athifashaffy/tsf-digital-twin/hardware/print/stl/box_lid.stl

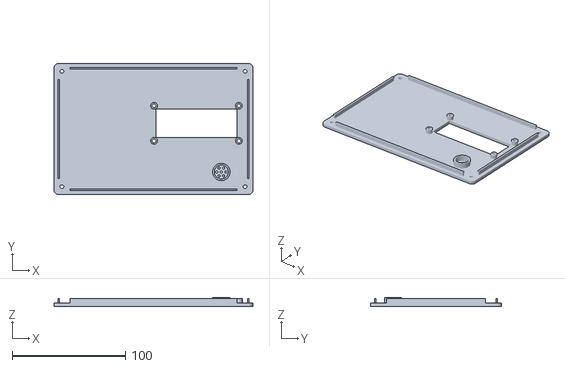
[picture p1: CAD file, 2026-10-17]
hardware/print/stl/box_lid.stl
176.0 x 116.0 x 8.00
