athifashaffy/tsf-digital-twin/hardware/print/stl/sonar_holder.stl

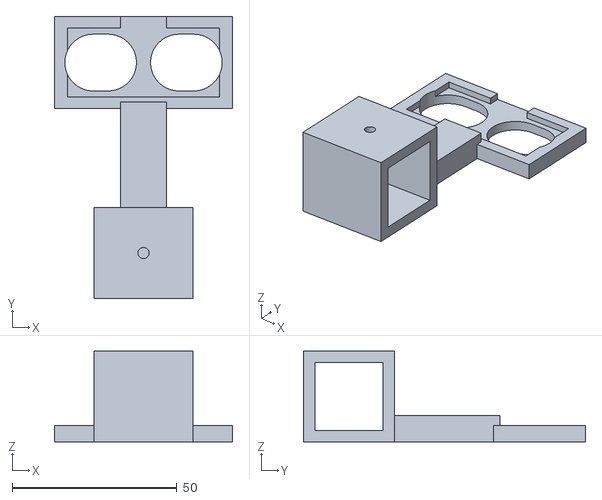
[picture p2: CAD file, 2026-10-17]
hardware/print/stl/sonar_holder.stl
54.0 x 85.6 x 27.6
