athifashaffy/tsf-digital-twin/hardware/print/stl/flow_cradle.stl

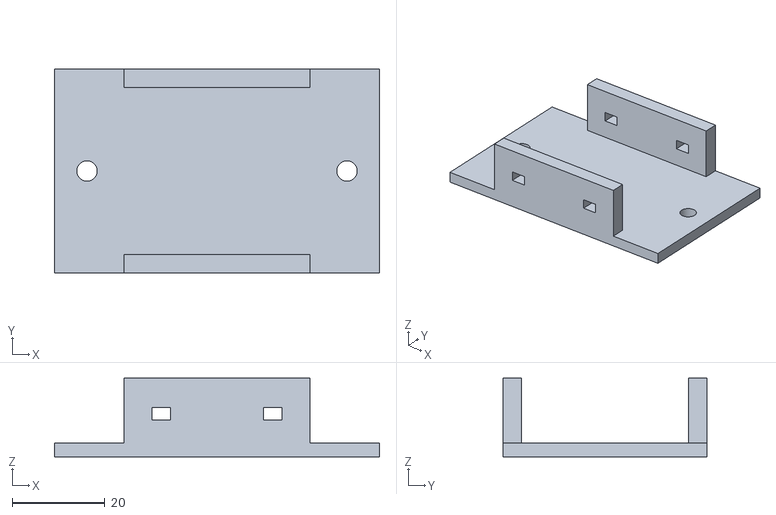
[picture p3: CAD file, 2026-10-17]
hardware/print/stl/flow_cradle.stl
70.0 x 44.0 x 17.0
