athifashaffy/tsf-digital-twin/hardware/print/stl/probe_hanger_x2.stl

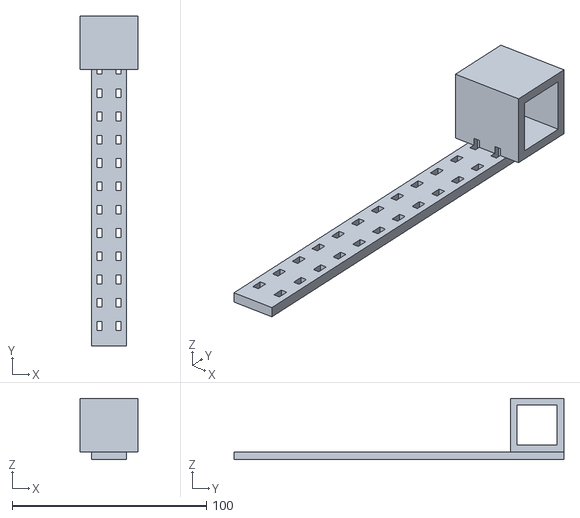
[picture p4: CAD file, 2026-10-17]
hardware/print/stl/probe_hanger_x2.stl
30.0 x 170.0 x 31.6
