athifashaffy/tsf-digital-twin/hardware/print/stl/rim_clamp_x2.stl

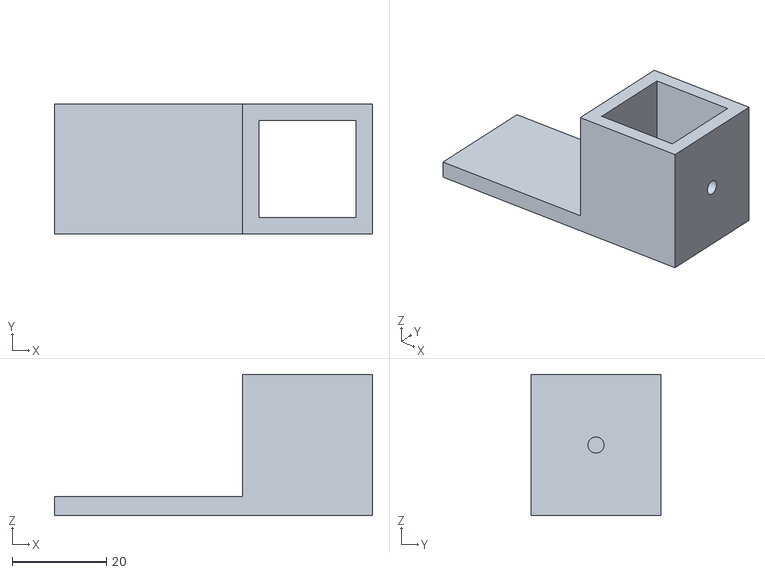
[picture p5: CAD file, 2026-10-17]
hardware/print/stl/rim_clamp_x2.stl
67.6 x 27.6 x 30.0
