athifashaffy/tsf-digital-twin/hardware/print/stl/saddle.stl

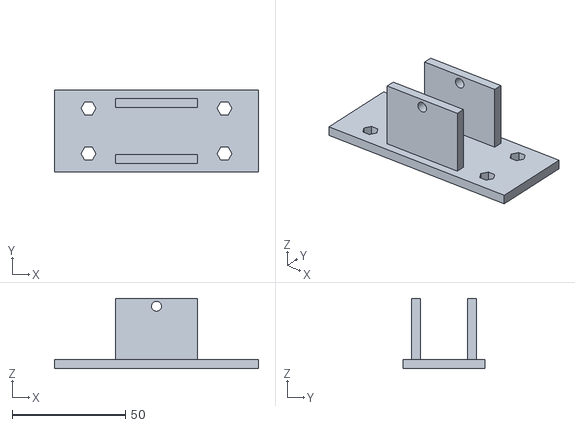
[picture p6: CAD file, 2026-10-17]
hardware/print/stl/saddle.stl
90.0 x 36.0 x 31.0
