athifashaffy/tsf-digital-twin/hardware/print/stl/box_base.stl

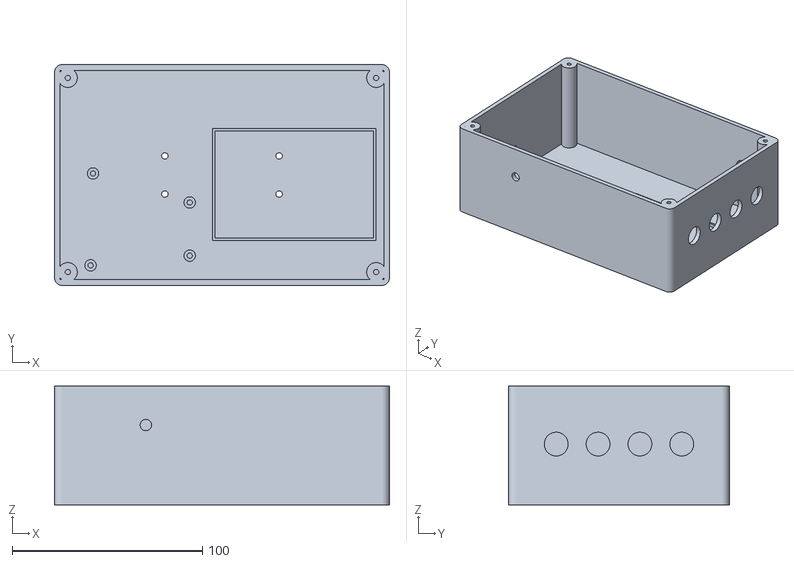
[picture p7: CAD file, 2026-10-17]
hardware/print/stl/box_base.stl
176.0 x 116.0 x 62.5
