athifashaffy/tsf-digital-twin/hardware/print/viewer.html

Ready to slice · 7 STL files

# TSF Rig Print Kit

The electronics box sits on a 20 mm square bar laid across the tank. The ultrasonic sensor hangs from the bar pointing straight down, and the probes hang on zip-tie arms. The 3D model below uses the same geometry as the STL files.

Loading model…

Tank Lift lid Auto-rotate Reset view Drag to rotate · scroll to zoom · right-drag to pan

Orange = printed parts, grey = the box, silver = the bar you buy. The tank is drawn at 40 × 30 × 29 cm; your bar length only needs to match your own tank.

## Files to print

The files are in hardware/print/stl/, already oriented flat-side-down for printing, so no supports are needed. To change a size, edit the constants at the top of make_parts.py and run it again.

File | Qty | Size (mm) | What it does
box_base.stl | 1 | 176 × 116 × 62.5 | Holds the Arduino (UNO standoffs) and the breadboard (retaining frame). Has a USB-C/DC window on the left, 4 cable glands on the right (LEVEL, FLOW, TURB, STRIP), 1 on the back (PUMP), and an IR hole on the front.
box_lid.stl | 1 | 176 × 116 × 8 | Has an LCD window with 4 M3 screw bosses, a buzzer grille and holder ring, and 4 counterbored corner screws. Prints face-down.
saddle.stl | 1 | 90 × 36 × 31 | Bolts under the box with 4 × M3 (nut traps) and grips the bar. An M4 bolt under the bar locks it in place.
rim_clamp_x2.stl | 2 | 68 × 28 × 30 | Slides onto the bar. Its finger rests against the inside of the tank wall so the bar can't slide sideways. Lock it with an M4 screw.
sonar_holder.stl | 1 | 54 × 86 × 28 | The HC-SR04 drops in with its transducers facing down. The holes are slotted to fit a 24–29 mm transducer spacing.
probe_hanger_x2.stl | 2 | 30 × 170 × 32 | One for the turbidity probe and one for the red water-level strip. Zip-tie each one at the depth you need.
flow_cradle.stl | 1 | 70 × 44 × 17 | Holds the YF-S201 on the outlet line, below the tank outlet. Zip ties go through the slots and 2 × M4 screws fix it to the bench.

## Buy before printing

- 20 × 20 mm square bar (aluminium tube or a wooden strip), about 7 cm longer than your tank's width. The bar size is the BAR constant in the script.
- 5 × PG7 cable glands (12.5 mm thread).
- M3 screws: 4 × 10 mm (lid), 4 × 6 mm (Arduino), 4 × 12 mm with nuts (LCD), 4 × 10 mm with nuts (box to saddle).
- M4 screws: 1 × 40 mm bolt with nut (saddle), 3 × 10 mm (thumb screws for the clamps and sonar holder), 2 × wood screws (cradle).
- Zip ties up to 2.5 mm wide, and some silicone sealant for around the lid if water splashes the box.

## Print settings

- PETG, 0.2 mm layers, 4 walls, 25% infill, no supports. PLA works if the parts stay dry.
- The box base takes about 6–7 h and the lid about 2 h on a typical 0.4 mm nozzle printer. All parts fit a 220 × 220 mm bed.
- Print one rim clamp first and test it on your bar. If it's too tight or too loose, change FIT (default 0.6 mm) and regenerate.
